jasongold/RSB5001/reference/Arduino-Wiring-Fritzing-Connections-with-16x2-Character-LCD.png

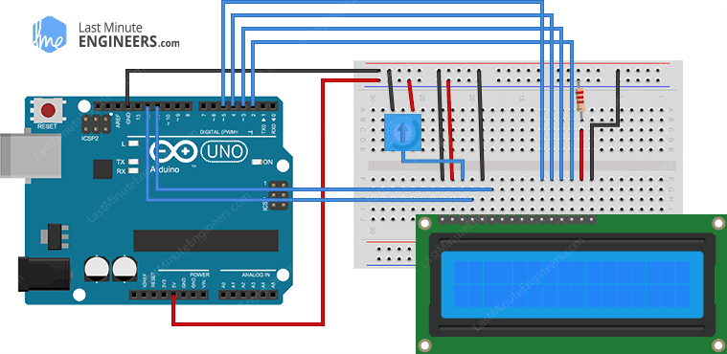
reference/Arduino-Wiring-Fritzing-Connections-with-16x2-Character-LCD.png
