jasongold/RSB5001/(commit log)

2026-08-18 chore: preserve unversioned sketches, wiring diagram and code review
    Three generations of this project existed only on local disk with no backup:
    - The Oct 2023 DFPlayer Mini version (the code the physical box actually runs)
    was never committed. It is the newest work and had no copy anywhere else.
    - Two Jun 2021 drafts lived unversioned in ../RSB5000/.
    - The Fritzing LCD wiring diagram in ../RSB5000/RSB5001/ was the only copy in
    existence.
    All are now under reference/ with a .ino.txt extension, since the Arduino IDE
    concatenates every .ino in a sketch folder into one translation unit and a
    second .ino would break the build.
    Also adds CODE-REVIEW.md and capitalises "Arduino" in the REA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
2026-08-18 refactor: rewrite around a player array and a non-blocking state machine
    Rebuilt from the Oct 2023 DFPlayer sketch (reference/), which is the version
    matching the wiring in the box. Roughly 200 of its 650 lines were the same block
    copy-pasted four times with the digit changed; those collapse into loops over a
    Player array, and the round becomes a state machine so nothing blocks.
    Fairness — the point of the game:
    - Register presses on the leading edge with a lockout after, instead of
    requiring 50 ms of stable input before accepting one. Every reaction time the
    old build reported included that 50 ms.
    - Give each button its own debounce timer. One shared timer meant any button's
    bounc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
2026-08-18 feat: add browser bench simulator, and fix solo "too slow" result
    The simulator ports the sketch's state machine to the browser so rounds can be
    played and the logic checked without flashing the board. Constants, screens and
    rules are taken from config.h and rsb5001.ino; it renders the LCD as a real 16x2
    character grid, the LED pairs, the status lamp and the serial output.
    Running scripted rounds through it found a bug in the sketch: enterResults()
    kills the solo player when they lose, and showSoloResult() was reading !alive as
    "drew too early". Losing honestly and jumping the gun both leave the player
    dead, so the "Too slow!" branch was unreachable and anyone who simply failed to
    draw in t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
    [game.cpp, game.h, rsb5001.ino]
2026-08-18 fix: stop every sound blocking for 500ms and eating button presses
    hardwareBegin() called dfPlayer.begin() with the library's default ACK mode and
    then forced audioReady = true when it failed. The failure is expected on this
    wiring - the SoftwareSerial RX pin cannot receive on a Mega - but leaving ACK
    enabled meant every subsequent command ran
    while (_isSending) { delay(0); waitAvailable(); }
    and waitAvailable() only gives up after a 500 ms timeout that can never be
    satisfied. Nothing else runs during that stall: buttonsPoll() is not called, so
    a player pressing and releasing inside the window has their press discarded.
    Ready, Steady, Bang and the hit sound meant roughly 2 seconds of d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
    [hardware.cpp]
2026-08-18 fix: recover the LCD from lost nibble sync at round boundaries
    The display intermittently fills with wrong characters. Those are real HD44780
    glyphs, so the controller is receiving data but has lost 4-bit nibble sync: a
    glitch on the enable line clocks in half a byte and every character after it is
    misread. lcd.clear() cannot fix this, because the clear command travels over the
    same desynced link - only the init sequence resyncs the controller, being
    designed to be understood from any state.
    This is what the 2023 sketch was working around by calling lcd.begin() eight
    times a round in place of lcd.clear(). Replacing that with clear() was correct
    for the ~50ms it saved in the timing path, but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
    [hardware.cpp, hardware.h, rsb5001.ino]
2026-08-18 fix: resync the LCD before every write, no rewiring needed
    Follows the previous commit, which only recovered the display at round
    boundaries. The garbling still had to be waited out for the rest of a round, so
    this resyncs before every screen change instead - the same brute-force approach
    the 2023 sketch used, without its cost.
    That sketch called lcd.begin() as its clear, at roughly 65 ms a time. Most of
    that is a 50 ms wait for the supply to rise after power-on, which a resync does
    not need. Sending only the parts that matter - three 8-bit function sets, the
    switch to 4-bit, then function set, display on, clear and entry mode - takes
    about 12 ms and leaves exactly the state LiquidCrystal c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
    [hardware.cpp, hardware.h, rsb5001.ino]
2026-08-20 feat: add a light show, and full colour on the centre lamp
    Everything here is decoration. It reads game state and drives the LEDs,
    the lamp and the screen, and never changes a rule.
    New cosmetics.h/.cpp holds it all, driven by a cosmeticsTick() that runs
    once per loop() pass and steps a pattern only when one is due.
    LEDs and lamp:
    - Menu breathes in the mode's colour; after 10s idle a chase sweeps the
    stations and the lamp turns to firelight.
    - Ready fills the blue LEDs in turn while the lamp charges green to white.
    - Steady pulses flat and beats flat. Neither may ever track
    steadyDurationMs, which would hand players the one thing the game
    depends on them not knowing.
    -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
